epfl-mobots/e-puck3-coreboard/Programmer_pinout_rev1.txt

Configuration	Programmer_pinout_rev1
STM32CubeMX 	5.5.0
Date	07/27/2020
MCU	STM32F746ZGYx

PERIPHERALS	MODES	FUNCTIONS	PINS
ADC1	IN0	ADC1_IN0	PA0/WKUP
ADC1	IN11	ADC1_IN11	PC1
ADC1	Single-ended	ADC1_TempSens_Input	VP_ADC1_TempSens_Input
ADC1	Vrefint Channel	ADC1_Vref_Input	VP_ADC1_Vref_Input
ADC2	IN4	ADC2_IN4	PA4
ADC2	IN5	ADC2_IN5	PA5
ADC2	IN6	ADC2_IN6	PA6
ADC2	IN9	ADC2_IN9	PB1
ADC2	IN12	ADC2_IN12	PC2
ADC2	IN13	ADC2_IN13	PC3
ADC2	IN14	ADC2_IN14	PC4
ADC2	IN15	ADC2_IN15	PC5
ADC3	IN1	ADC3_IN1	PA1
ADC3	IN2	ADC3_IN2	PA2
ADC3	IN3	ADC3_IN3	PA3
ADC3	IN4	ADC3_IN4	PF6
ADC3	IN5	ADC3_IN5	PF7
ADC3	IN6	ADC3_IN6	PF8
ADC3	IN7	ADC3_IN7	PF9
ADC3	IN8	ADC3_IN8	PF10
ADC3	IN9	ADC3_IN9	PF3
ADC3	IN10	ADC3_IN10	PC0
ADC3	IN14	ADC3_IN14	PF4
ADC3	IN15	ADC3_IN15	PF5
CAN1	Master	CAN1_RX	PD0
CAN1	Master	CAN1_TX	PD1
I2C4	I2C	I2C4_SCL	PF14
I2C4	I2C	I2C4_SDA	PD13
RCC	BYPASS Clock Source	RCC_OSC_IN	PH0/OSC_IN
RCC	BYPASS Clock Source	RCC_OSC_OUT	PH1/OSC_OUT
SPI6	Full-Duplex Master	SPI6_MISO	PG12
SPI6	Full-Duplex Master	SPI6_MOSI	PG14
SPI6	Full-Duplex Master	SPI6_SCK	PG13
SYS	Serial Wire	SYS_JTCK-SWCLK	PA14
SYS	Serial Wire	SYS_JTMS-SWDIO	PA13
SYS	SysTick	SYS_VS_Systick	VP_SYS_VS_Systick
TIM1	ITR0	TIM1_VS_ClockSourceITR	VP_TIM1_VS_ClockSourceITR
TIM1	Internal Clock	TIM1_VS_ClockSourceINT	VP_TIM1_VS_ClockSourceINT
TIM1	PWM Generation CH1 CH1N	TIM1_CH1	PE9
TIM1	PWM Generation CH1 CH1N	TIM1_CH1N	PE8
TIM1	PWM Generation CH2 CH2N	TIM1_CH2	PE11
TIM1	PWM Generation CH2 CH2N	TIM1_CH2N	PE10
TIM1	PWM Generation CH3 CH3N	TIM1_CH3	PE13
TIM1	PWM Generation CH3 CH3N	TIM1_CH3N	PE12
TIM2	Trigger Mode	TIM2_VS_ControllerModeTrigger	VP_TIM2_VS_ControllerModeTrigger
TIM2	ITR0	TIM2_VS_ClockSourceITR	VP_TIM2_VS_ClockSourceITR
TIM2	Internal Clock	TIM2_VS_ClockSourceINT	VP_TIM2_VS_ClockSourceINT
TIM2	PWM Generation CH1	TIM2_CH1	PA15
TIM2	PWM Generation CH2	TIM2_CH2	PB3
TIM2	PWM Generation CH3	TIM2_CH3	PB10
TIM2	PWM Generation CH4	TIM2_CH4	PB11
TIM3	Trigger Mode	TIM3_VS_ControllerModeTrigger	VP_TIM3_VS_ControllerModeTrigger
TIM3	ITR0	TIM3_VS_ClockSourceITR	VP_TIM3_VS_ClockSourceITR
TIM3	PWM Generation CH1	TIM3_CH1	PB4
TIM3	PWM Generation CH2	TIM3_CH2	PB5
TIM3	PWM Generation CH3	TIM3_CH3	PB0
TIM3	PWM Generation CH4	TIM3_CH4	PC9
TIM4	Trigger Mode	TIM4_VS_ControllerModeTrigger	VP_TIM4_VS_ControllerModeTrigger
TIM4	ITR0	TIM4_VS_ClockSourceITR	VP_TIM4_VS_ClockSourceITR
TIM4	Internal Clock	TIM4_VS_ClockSourceINT	VP_TIM4_VS_ClockSourceINT
TIM4	PWM Generation CH1	TIM4_CH1	PD12
TIM4	PWM Generation CH2	TIM4_CH2	PB7
TIM4	PWM Generation CH3	TIM4_CH3	PD14
TIM4	PWM Generation CH4	TIM4_CH4	PD15
TIM8	Trigger Mode	TIM8_VS_ControllerModeTrigger	VP_TIM8_VS_ControllerModeTrigger
TIM8	ITR0	TIM8_VS_ClockSourceITR	VP_TIM8_VS_ClockSourceITR
TIM8	Internal Clock	TIM8_VS_ClockSourceINT	VP_TIM8_VS_ClockSourceINT
TIM8	PWM Generation CH1 CH1N	TIM8_CH1	PC6
TIM8	PWM Generation CH1 CH1N	TIM8_CH1N	PA7
TIM8	PWM Generation CH2 CH2N	TIM8_CH2	PC7
TIM8	PWM Generation CH2 CH2N	TIM8_CH2N	PB14
TIM8	PWM Generation CH3 CH3N	TIM8_CH3	PC8
TIM8	PWM Generation CH3 CH3N	TIM8_CH3N	PB15
UART8	Asynchronous	UART8_RX	PE0
UART8	Asynchronous	UART8_TX	PE1
USART1	Asynchronous	USART1_RX	PA10
USART1	Asynchronous	USART1_TX	PB6
USART3	Asynchronous	USART3_RX	PC11
USART3	Asynchronous	USART3_TX	PC10
USB_OTG_FS	Device_Only	USB_OTG_FS_DM	PA11
USB_OTG_FS	Device_Only	USB_OTG_FS_DP	PA12
USB_OTG_FS	VBUS	USB_OTG_FS_VBUS	PA9

Pin Nb	PINs	FUNCTIONs	LABELs
A2	PC10	USART3_TX	UART_uC_ESP_TX
A3	PD2	GPIO_Output	STATUS_LED1_R
A4	PD5	GPIO_Output	STATUS_LED2_R
A5	PD7	GPIO_Output	STATUS_LED2_B
A6	PG12	SPI6_MISO	ENCODERS_GATE_DRIVERS
A8	PB6	USART1_TX	UART_PROG_ESP
A9	PB8	GPIO_Output	EN_ESP32
A10	PE1	UART8_TX	UART_CMD
B1	PA14	SYS_JTCK-SWCLK	
B2	PC11	USART3_RX	UART_uC_ESP_RX
B3	PD0	CAN1_RX	
B4	PD3	GPIO_Output	STATUS_LED1_G
B5	PD4	GPIO_Output	STATUS_LED1_B
B6	PG11	GPIO_Output	EN_DRIVER_3
B7	PB3	TIM2_CH2	H_bridge_mot2AN
B8	PB7	TIM4_CH2	H_bridge_mot3BN
B9	PB9	GPIO_Output	GPIO0_ESP32
B10	PE0	UART8_RX	UART_CMD
C2	PA15	TIM2_CH1	H_bridge_mot2AP
C3	PC12	GPIO_Output	EN_EXTENSION_TOP
C4	PD1	CAN1_TX	
C6	PG10	GPIO_EXTI10	PWR_ON_BTN_STATE_n
C7	PB4	TIM3_CH1	H_bridge_mot2CP
C8	PB5	TIM3_CH2	H_bridge_mot2CN
C10	PE3	GPIO_Output	GPIO4_ESP32
D3	PA13	SYS_JTMS-SWDIO	
D4	PA11	USB_OTG_FS_DM	
D5	PA10	USART1_RX	UART_PROG_ESP
D6	PG13	SPI6_SCK	ENCODERS_GATE_DRIVERS
D8	PE2	GPIO_Output	EN_DRIVER_4
D9	PE5	GPIO_Output	SWD_uC_SWCLK
E1	PA12	USB_OTG_FS_DP	
E2	PA9	USB_OTG_FS_VBUS	
E3	PC9	TIM3_CH4	H_bridge_mot3AN
E4	PC8	TIM8_CH3	H_bridge_mot4CP
E5	PG9	GPIO_Output	EN_EXTENSION_BOTTOM
E8	PE6	GPIO_Output	SWD_uC_SWDIO
E9	PF1	GPIO_Output	HUB_CONNECT
F1	PA8	GPIO_Output	RESET_HUB_n
F2	PC6	TIM8_CH1	H_bridge_mot4AP
F3	PC7	TIM8_CH2	H_bridge_mot4BP
F4	PD6	GPIO_Output	STATUS_LED2_G
F6	PG14	SPI6_MOSI	ENCODERS_GATE_DRIVERS
F7	PF7	ADC3_IN5	Brushless_sense_mot1A
F8	PF5	ADC3_IN15	Brushless_sense_mot1C
F9	PF4	ADC3_IN14	Brushless_sense_mot1B
F10	PF2	GPIO_Output	EN_DRIVER_2
F11	PF0	GPIO_Output	GPIO13_ESP32
G2	PG8	GPIO_Output	BYPASS_HUB_n
G3	PG3	GPIO_EXTI3	FAULT_DRIVER_3_n
G4	PG6	GPIO_Output	VBUS_DEVICES
G5	PG4	GPIO_EXTI4	VBUS_HOST
G6	PG5	GPIO_EXTI5	INT_PD_CTRL_n
G8	PF9	ADC3_IN7	Brushless_sense_mot2A
G9	PF10	ADC3_IN8	Brushless_sense_mot2B
G10	PF6	ADC3_IN4	Brushless_sense_mot3A
G11	PF3	ADC3_IN9	Brushless_sense_mot3C
H4	PD10	GPIO_Output	STATUS_LED3_B
H5	PD13	I2C4_SDA	I2C_PD_CONTROLLER
H6	PD12	TIM4_CH1	H_bridge_mot3BP
H8	PC0	ADC3_IN10	Brushless_sense_mot2C
H10	PH1/OSC_OUT	RCC_OSC_OUT	
H11	PF8	ADC3_IN6	Brushless_sense_mot3B
J1	PG2	GPIO_EXTI2	FAULT_DRIVER_4_n
J2	PD14	TIM4_CH3	H_bridge_mot3CP
J3	PB15	TIM8_CH3N	H_bridge_mot4CN
J4	PE10	TIM1_CH2N	H_bridge_mot1BN
J9	PC3	ADC2_IN13	Current_sense_mot1B
J10	PC2	ADC2_IN12	Current_sense_mot1A
J11	PH0/OSC_IN	RCC_OSC_IN	_24MHz_IN
K1	PD15	TIM4_CH4	H_bridge_mot3CN
K2	PD11	GPIO_Output	CS_ENCODER1_n
K3	PB14	TIM8_CH2N	H_bridge_mot4BN
K4	PE11	TIM1_CH2	H_bridge_mot1BP
K5	PG1	GPIO_EXTI1	FAULT_DRIVER_2_n
K6	PF13	GPIO_Output	CS_ENCODER4_n
K7	PB1	ADC2_IN9	Current_sense_mot4A
K8	PA1	ADC3_IN1	Brushless_sense_mot4A
K9	PA0/WKUP	ADC1_IN0	VBUS_sense
K11	PC1	ADC1_IN11	BAT+_sense
L2	PD8	GPIO_Output	STATUS_LED3_R
L3	PE15	GPIO_Output	RESET_uC
L4	PE12	TIM1_CH3N	H_bridge_mot1CN
L5	PE7	GPIO_Output	CS_ENCODER2_n
L6	PF14	I2C4_SCL	I2C_PD_CONTROLLER
L7	PB2	GPIO_Output	BAT+_INRUSH_LIMIT_n
L8	PA7	TIM8_CH1N	H_bridge_mot4AN
L9	PA2	ADC3_IN2	Brushless_sense_mot4B
M1	PD9	GPIO_Output	STATUS_LED3_G
M2	PB12	GPIO_Output	PWR_ON
M3	PB10	TIM2_CH3	H_bridge_mot2BP
M4	PE14	GPIO_Output	CS_ENCODER3_n
M5	PE8	TIM1_CH1N	H_bridge_mot1AN
M6	PF15	GPIO_Output	EN_DRIVER_1
M7	PF11	GPIO_Output	PRIORITY_TO_VBUS
M8	PC4	ADC2_IN14	Current_sense_mot4B
M9	PA5	ADC2_IN5	Current_sense_mot2B
M10	PA4	ADC2_IN4	Current_sense_mot2A
M11	PA3	ADC3_IN3	Brushless_sense_mot4C
N1	PB13	GPIO_Output	EN_CAN_PROG_n
N3	PB11	TIM2_CH4	H_bridge_mot2BN
N4	PE13	TIM1_CH3	H_bridge_mot1CP
N5	PE9	TIM1_CH1	H_bridge_mot1AP
N6	PG0	GPIO_EXTI0	FAULT_DRIVER_1_n
N8	PB0	TIM3_CH3	H_bridge_mot3AP
N9	PC5	ADC2_IN15	Current_sense_mot3B
N10	PA6	ADC2_IN6	Current_sense_mot3A
PERIPHERALS	MODES	FUNCTIONS	PINS
ADC1	IN0	ADC1_IN0	PA0/WKUP
ADC1	IN11	ADC1_IN11	PC1
ADC1	Single-ended	ADC1_TempSens_Input	VP_ADC1_TempSens_Input
ADC1	Vrefint Channel	ADC1_Vref_Input	VP_ADC1_Vref_Input
ADC2	IN4	ADC2_IN4	PA4
ADC2	IN5	ADC2_IN5	PA5
ADC2	IN6	ADC2_IN6	PA6
ADC2	IN9	ADC2_IN9	PB1
ADC2	IN12	ADC2_IN12	PC2
ADC2	IN13	ADC2_IN13	PC3
ADC2	IN14	ADC2_IN14	PC4
ADC2	IN15	ADC2_IN15	PC5
ADC3	IN1	ADC3_IN1	PA1
ADC3	IN2	ADC3_IN2	PA2
ADC3	IN3	ADC3_IN3	PA3
ADC3	IN4	ADC3_IN4	PF6
ADC3	IN5	ADC3_IN5	PF7
ADC3	IN6	ADC3_IN6	PF8
ADC3	IN7	ADC3_IN7	PF9
ADC3	IN8	ADC3_IN8	PF10
ADC3	IN9	ADC3_IN9	PF3
ADC3	IN10	ADC3_IN10	PC0
ADC3	IN14	ADC3_IN14	PF4
ADC3	IN15	ADC3_IN15	PF5
CAN1	Master	CAN1_RX	PD0
CAN1	Master	CAN1_TX	PD1
I2C4	I2C	I2C4_SCL	PF14
I2C4	I2C	I2C4_SDA	PD13
RCC	BYPASS Clock Source	RCC_OSC_IN	PH0/OSC_IN
RCC	BYPASS Clock Source	RCC_OSC_OUT	PH1/OSC_OUT
SPI6	Full-Duplex Master	SPI6_MISO	PG12
SPI6	Full-Duplex Master	SPI6_MOSI	PG14
SPI6	Full-Duplex Master	SPI6_SCK	PG13
SYS	Serial Wire	SYS_JTCK-SWCLK	PA14
SYS	Serial Wire	SYS_JTMS-SWDIO	PA13
SYS	SysTick	SYS_VS_Systick	VP_SYS_VS_Systick
TIM1	ITR0	TIM1_VS_ClockSourceITR	VP_TIM1_VS_ClockSourceITR
TIM1	Internal Clock	TIM1_VS_ClockSourceINT	VP_TIM1_VS_ClockSourceINT
TIM1	PWM Generation CH1 CH1N	TIM1_CH1	PE9
TIM1	PWM Generation CH1 CH1N	TIM1_CH1N	PE8
TIM1	PWM Generation CH2 CH2N	TIM1_CH2	PE11
TIM1	PWM Generation CH2 CH2N	TIM1_CH2N	PE10
TIM1	PWM Generation CH3 CH3N	TIM1_CH3	PE13
TIM1	PWM Generation CH3 CH3N	TIM1_CH3N	PE12
TIM2	Trigger Mode	TIM2_VS_ControllerModeTrigger	VP_TIM2_VS_ControllerModeTrigger
TIM2	ITR0	TIM2_VS_ClockSourceITR	VP_TIM2_VS_ClockSourceITR
TIM2	Internal Clock	TIM2_VS_ClockSourceINT	VP_TIM2_VS_ClockSourceINT
TIM2	PWM Generation CH1	TIM2_CH1	PA15
TIM2	PWM Generation CH2	TIM2_CH2	PB3
TIM2	PWM Generation CH3	TIM2_CH3	PB10
TIM2	PWM Generation CH4	TIM2_CH4	PB11
TIM3	Trigger Mode	TIM3_VS_ControllerModeTrigger	VP_TIM3_VS_ControllerModeTrigger
TIM3	ITR0	TIM3_VS_ClockSourceITR	VP_TIM3_VS_ClockSourceITR
TIM3	PWM Generation CH1	TIM3_CH1	PB4
TIM3	PWM Generation CH2	TIM3_CH2	PB5
TIM3	PWM Generation CH3	TIM3_CH3	PB0
TIM3	PWM Generation CH4	TIM3_CH4	PC9
TIM4	Trigger Mode	TIM4_VS_ControllerModeTrigger	VP_TIM4_VS_ControllerModeTrigger
TIM4	ITR0	TIM4_VS_ClockSourceITR	VP_TIM4_VS_ClockSourceITR
TIM4	Internal Clock	TIM4_VS_ClockSourceINT	VP_TIM4_VS_ClockSourceINT
TIM4	PWM Generation CH1	TIM4_CH1	PD12
TIM4	PWM Generation CH2	TIM4_CH2	PB7
TIM4	PWM Generation CH3	TIM4_CH3	PD14
TIM4	PWM Generation CH4	TIM4_CH4	PD15
TIM8	Trigger Mode	TIM8_VS_ControllerModeTrigger	VP_TIM8_VS_ControllerModeTrigger
TIM8	ITR0	TIM8_VS_ClockSourceITR	VP_TIM8_VS_ClockSourceITR
TIM8	Internal Clock	TIM8_VS_ClockSourceINT	VP_TIM8_VS_ClockSourceINT
TIM8	PWM Generation CH1 CH1N	TIM8_CH1	PC6
TIM8	PWM Generation CH1 CH1N	TIM8_CH1N	PA7
TIM8	PWM Generation CH2 CH2N	TIM8_CH2	PC7
TIM8	PWM Generation CH2 CH2N	TIM8_CH2N	PB14
TIM8	PWM Generation CH3 CH3N	TIM8_CH3	PC8
TIM8	PWM Generation CH3 CH3N	TIM8_CH3N	PB15
UART8	Asynchronous	UART8_RX	PE0
UART8	Asynchronous	UART8_TX	PE1
USART1	Asynchronous	USART1_RX	PA10
USART1	Asynchronous	USART1_TX	PB6
USART3	Asynchronous	USART3_RX	PC11
USART3	Asynchronous	USART3_TX	PC10
USB_OTG_FS	Device_Only	USB_OTG_FS_DM	PA11
USB_OTG_FS	Device_Only	USB_OTG_FS_DP	PA12
USB_OTG_FS	VBUS	USB_OTG_FS_VBUS	PA9

Pin Nb	PINs	FUNCTIONs	LABELs
A2	PC10	USART3_TX	UART_uC_ESP_TX
A3	PD2	GPIO_Output	STATUS_LED1_R
A4	PD5	GPIO_Output	STATUS_LED2_R
A5	PD7	GPIO_Output	STATUS_LED2_B
A6	PG12	SPI6_MISO	ENCODERS_GATE_DRIVERS
A8	PB6	USART1_TX	UART_PROG_ESP
A9	PB8	GPIO_Output	EN_ESP32
A10	PE1	UART8_TX	UART_CMD
B1	PA14	SYS_JTCK-SWCLK	
B2	PC11	USART3_RX	UART_uC_ESP_RX
B3	PD0	CAN1_RX	
B4	PD3	GPIO_Output	STATUS_LED1_G
B5	PD4	GPIO_Output	STATUS_LED1_B
B6	PG11	GPIO_Output	EN_DRIVER_3
B7	PB3	TIM2_CH2	H_bridge_mot2AN
B8	PB7	TIM4_CH2	H_bridge_mot3BN
B9	PB9	GPIO_Output	GPIO0_ESP32
B10	PE0	UART8_RX	UART_CMD
C2	PA15	TIM2_CH1	H_bridge_mot2AP
C3	PC12	GPIO_Output	EN_EXTENSION_TOP
C4	PD1	CAN1_TX	
C6	PG10	GPIO_EXTI10	PWR_ON_BTN_STATE_n
C7	PB4	TIM3_CH1	H_bridge_mot2CP
C8	PB5	TIM3_CH2	H_bridge_mot2CN
C10	PE3	GPIO_Output	GPIO4_ESP32
D3	PA13	SYS_JTMS-SWDIO	
D4	PA11	USB_OTG_FS_DM	
D5	PA10	USART1_RX	UART_PROG_ESP
D6	PG13	SPI6_SCK	ENCODERS_GATE_DRIVERS
D8	PE2	GPIO_Output	EN_DRIVER_4
D9	PE5	GPIO_Output	SWD_uC_SWCLK
E1	PA12	USB_OTG_FS_DP	
E2	PA9	USB_OTG_FS_VBUS	
E3	PC9	TIM3_CH4	H_bridge_mot3AN
E4	PC8	TIM8_CH3	H_bridge_mot4CP
E5	PG9	GPIO_Output	EN_EXTENSION_BOTTOM
E8	PE6	GPIO_Output	SWD_uC_SWDIO
E9	PF1	GPIO_Output	HUB_CONNECT
F1	PA8	GPIO_Output	RESET_HUB_n
F2	PC6	TIM8_CH1	H_bridge_mot4AP
F3	PC7	TIM8_CH2	H_bridge_mot4BP
F4	PD6	GPIO_Output	STATUS_LED2_G
F6	PG14	SPI6_MOSI	ENCODERS_GATE_DRIVERS
F7	PF7	ADC3_IN5	Brushless_sense_mot1A
F8	PF5	ADC3_IN15	Brushless_sense_mot1C
F9	PF4	ADC3_IN14	Brushless_sense_mot1B
F10	PF2	GPIO_Output	EN_DRIVER_2
F11	PF0	GPIO_Output	GPIO13_ESP32
G2	PG8	GPIO_Output	BYPASS_HUB_n
G3	PG3	GPIO_EXTI3	FAULT_DRIVER_3_n
G4	PG6	GPIO_Output	VBUS_DEVICES
G5	PG4	GPIO_EXTI4	VBUS_HOST
G6	PG5	GPIO_EXTI5	INT_PD_CTRL_n
G8	PF9	ADC3_IN7	Brushless_sense_mot2A
G9	PF10	ADC3_IN8	Brushless_sense_mot2B
G10	PF6	ADC3_IN4	Brushless_sense_mot3A
G11	PF3	ADC3_IN9	Brushless_sense_mot3C
H4	PD10	GPIO_Output	STATUS_LED3_B
H5	PD13	I2C4_SDA	I2C_PD_CONTROLLER
H6	PD12	TIM4_CH1	H_bridge_mot3BP
H8	PC0	ADC3_IN10	Brushless_sense_mot2C
H10	PH1/OSC_OUT	RCC_OSC_OUT	
H11	PF8	ADC3_IN6	Brushless_sense_mot3B
J1	PG2	GPIO_EXTI2	FAULT_DRIVER_4_n
J2	PD14	TIM4_CH3	H_bridge_mot3CP
J3	PB15	TIM8_CH3N	H_bridge_mot4CN
J4	PE10	TIM1_CH2N	H_bridge_mot1BN
J9	PC3	ADC2_IN13	Current_sense_mot1B
J10	PC2	ADC2_IN12	Current_sense_mot1A
J11	PH0/OSC_IN	RCC_OSC_IN	_24MHz_IN
K1	PD15	TIM4_CH4	H_bridge_mot3CN
K2	PD11	GPIO_Output	CS_ENCODER1_n
K3	PB14	TIM8_CH2N	H_bridge_mot4BN
K4	PE11	TIM1_CH2	H_bridge_mot1BP
K5	PG1	GPIO_EXTI1	FAULT_DRIVER_2_n
K6	PF13	GPIO_Output	CS_ENCODER4_n
K7	PB1	ADC2_IN9	Current_sense_mot4A
K8	PA1	ADC3_IN1	Brushless_sense_mot4A
K9	PA0/WKUP	ADC1_IN0	VBUS_sense
K11	PC1	ADC1_IN11	BAT+_sense
L2	PD8	GPIO_Output	STATUS_LED3_R
L3	PE15	GPIO_Output	RESET_uC
L4	PE12	TIM1_CH3N	H_bridge_mot1CN
L5	PE7	GPIO_Output	CS_ENCODER2_n
L6	PF14	I2C4_SCL	I2C_PD_CONTROLLER
L7	PB2	GPIO_Output	BAT+_INRUSH_LIMIT_n
L8	PA7	TIM8_CH1N	H_bridge_mot4AN
L9	PA2	ADC3_IN2	Brushless_sense_mot4B
M1	PD9	GPIO_Output	STATUS_LED3_G
M2	PB12	GPIO_Output	PWR_ON
M3	PB10	TIM2_CH3	H_bridge_mot2BP
M4	PE14	GPIO_Output	CS_ENCODER3_n
M5	PE8	TIM1_CH1N	H_bridge_mot1AN
M6	PF15	GPIO_Output	EN_DRIVER_1
M7	PF11	GPIO_Output	PRIORITY_TO_VBUS
M8	PC4	ADC2_IN14	Current_sense_mot4B
M9	PA5	ADC2_IN5	Current_sense_mot2B
M10	PA4	ADC2_IN4	Current_sense_mot2A
M11	PA3	ADC3_IN3	Brushless_sense_mot4C
N1	PB13	GPIO_Output	EN_CAN_PROG_n
N3	PB11	TIM2_CH4	H_bridge_mot2BN
N4	PE13	TIM1_CH3	H_bridge_mot1CP
N5	PE9	TIM1_CH1	H_bridge_mot1AP
N6	PG0	GPIO_EXTI0	FAULT_DRIVER_1_n
N8	PB0	TIM3_CH3	H_bridge_mot3AP
N9	PC5	ADC2_IN15	Current_sense_mot3B
N10	PA6	ADC2_IN6	Current_sense_mot3A

SOFTWARE PROJECT

Project Settings : 
Project Name : Programmer_pinout_rev1
Project Folder : /Users/eliot/Documents/SmartGit/e-puck3-coreboard
Toolchain / IDE : EWARM V8
Firmware Package Name and Version : STM32Cube FW_F7 V1.15.0

Code Generation Settings : 
STM32Cube MCU packages and embedded software packs : Copy all used libraries into the project folder
Generate peripheral initialization as a pair of '.c/.h' files per peripheral : No
Backup previously generated files when re-generating : No
Delete previously generated files when not re-generated : Yes
Set all free pins as analog (to optimize the power consumption) : No

Toolchains Settings : 
Compiler Optimizations :
