epfl-mobots/e-puck3-coreboard/(list of files, drawings)

Other design files:
Camera_sdcard.SchDoc
e-puck3-coreboard.PrjPcb
e-puck3-coreboard_panel.PcbDoc
ESC_2S-5S.SchDoc
Extension_Connectors.SchDoc
Leds.SchDoc
Main.SchDoc
Main_uC.SchDoc
Power.SchDoc
Programmer.SchDoc
Schlib.SchLib
Sensors + CAN.SchDoc
USB.SchDoc
Wireless.SchDoc
