epfl-mobots/e-puck3-coreboard/Main_uC_pinout_rev1.1.ioc

Mcu.UserName=STM32F779AIYx
PA0/WKUP.Signal=ADCx_IN0
PA1.Signal=ADCx_IN1
PA10.Signal=DCMI_D1
PA11.Signal=USB_OTG_FS_DM
PA12.Signal=USB_OTG_FS_DP
PA13.Signal=SYS_JTMS-SWDIO
PA14.Signal=SYS_JTCK-SWCLK
PA15.Signal=UART7_TX
PA2.Signal=ADCx_IN2
PA3.Signal=USB_OTG_HS_ULPI_D0
PA4.Signal=COMP_DAC1_group
PA5.Signal=USB_OTG_HS_ULPI_CK
PA6.Signal=DCMI_PIXCLK
PA7.GPIO_Label=SDMC_DET_n
PA7.Signal=GPIO_Input
PA8.GPIO_Label=MHz_26_clk_out
PA8.Signal=RCC_MCO_1
PA9.Signal=USB_OTG_FS_VBUS
PB0.Signal=USB_OTG_HS_ULPI_D1
PB1.Signal=USB_OTG_HS_ULPI_D2
PB10.Signal=USB_OTG_HS_ULPI_D3
PB11.Signal=USB_OTG_HS_ULPI_D4
PB12.Signal=USB_OTG_HS_ULPI_D5
PB13.Signal=USB_OTG_HS_ULPI_D6
PB14.GPIO_Label=SPI_IMU_PRESS
PB14.Signal=SPI2_MISO
PB15.GPIO_Label=SPI_IMU_PRESS
PB15.Signal=SPI2_MOSI
PB2.GPIO_Label=SPI_EPS32
PB2.Signal=SPI3_MOSI
PB3.GPIO_Label=SPI_EPS32
PB3.Signal=SPI3_SCK
PB4.GPIO_Label=SPI_EPS32
PB4.Signal=SPI3_MISO
PB5.Signal=USB_OTG_HS_ULPI_D7
PB6.Signal=I2C1_SCL
PB7.Signal=I2C1_SDA
PB8.GPIO_Label=UART_ESP32_PROG
PB8.Signal=UART5_RX
PB9.GPIO_Label=UART_ESP32_PROG
PB9.Signal=UART5_TX
PC0.Signal=USB_OTG_HS_ULPI_STP
PC1.Signal=ADCx_IN11
PC10.Signal=SDMMC1_D2
PC11.Signal=SDMMC1_D3
PC12.Signal=SDMMC1_CK
PC6.Signal=USART6_TX
PC7.Signal=USART6_RX
PC8.Signal=SDMMC1_D0
PC9.Signal=SDMMC1_D1
PD0.Signal=CAN1_RX
PD1.Signal=CAN1_TX
PD10.Signal=S_CKOUTDFSDM1
PD11.GPIO_Label=PRESS_INT
PD11.Signal=GPIO_Input
PD12.Signal=I2C4_SCL
PD13.Signal=I2C4_SDA
PD14.GPIO_Label=FORCE_MAIN_UC
PD14.Signal=GPIO_Output
PD15.GPIO_Label=EXTCLK_camera
PD15.Signal=S_TIM4_CH4
PD2.Signal=SDMMC1_CMD
PD3.GPIO_Label=SPI_IMU_PRESS
PD3.Signal=SPI2_SCK
PD4.GPIO_Label=IMU_INT1
PD4.Signal=GPIO_Input
PD5.Signal=USART2_TX
PD6.Signal=USART2_RX
PD7.Signal=SPI1_MOSI
PD8.GPIO_Label=UART_CMD_PROG
PD8.Signal=USART3_TX
PD9.GPIO_Label=UART_CMD_PROG
PD9.Signal=USART3_RX
PE0.GPIO_Label=OE_CAM1_n
PE0.Signal=GPIO_Output
PE1.GPIO_Label=OE_CAM2_n
PE1.Signal=GPIO_Output
PE10.Signal=UART7_CTS
PE11.GPIO_Label=SPI_ESP_CS_n
PE11.Signal=GPIO_Output
PE12.GPIO_Label=MIC34
PE12.Signal=S_DATAIN5DFSDM1
PE13.GPIO_Label=FRONT_RGB_R
PE13.Signal=GPIO_Output
PE14.GPIO_Label=FRONT_RGB_G
PE14.Signal=GPIO_Output
PE15.GPIO_Label=FRONT_RGB_B
PE15.Signal=GPIO_Output
PE2.Signal=SPI4_SCK
PE3.GPIO_Label=IR_SIGNAL
PE3.Signal=GPIO_Input
PE4.GPIO_Label=MIC12
PE4.Signal=S_DATAIN3DFSDM1
PE5.Signal=SPI4_MISO
PE6.Signal=SPI4_MOSI
PE7.Signal=UART7_RX
PE8.GPIO_Label=IMU_INT2
PE8.Signal=GPIO_Input
PE9.Signal=UART7_RTS
PF0.GPIO_Label=USER_BUTTON_n
PF0.Signal=GPIO_Input
PF1.Signal=I2C2_SCL
PF10.Signal=ADC3_IN8
PF11.GPIO_Label=CS_IMU_n
PF11.Signal=GPIO_Output
PF12.GPIO_Label=CS_PRESS_n
PF12.Signal=GPIO_Output
PF13.GPIO_Label=RIGHT_RGB_R
PF13.Signal=GPIO_Output
PF14.GPIO_Label=RIGHT_RGB_G
PF14.Signal=GPIO_Output
PF15.GPIO_Label=RIGHT_RGB_B
PF15.Signal=GPIO_Output
PF2.GPIO_Label=POWER_ON
PF2.Signal=GPIO_Output
PF3.Signal=ADC3_IN9
PF4.Signal=ADC3_IN14
PF5.Signal=ADC3_IN15
PG0.GPIO_Label=REAR_RGB_R
PG0.Signal=GPIO_Output
PG1.GPIO_Label=REAR_RGB_G
PG1.Signal=GPIO_Output
PG10.Signal=DCMI_D2
PG11.Signal=SPI1_SCK
PG12.Signal=USART6_RTS
PG13.Signal=USART6_CTS
PG15.GPIO_Label=EN_CAN_uC_n
PG15.Signal=GPIO_Output
PG2.GPIO_Label=REAR_RGB_B
PG2.Signal=GPIO_Output
PG3.GPIO_Label=LEFT_RGB_R
PG3.Signal=GPIO_Output
PG4.GPIO_Label=LEFT_RGB_G
PG4.Signal=GPIO_Output
PG5.GPIO_Label=LEFT_RGB_B
PG5.Signal=GPIO_Output
PG7.GPIO_Label=SWCLK_prog
PG7.Signal=GPIO_Output
PG8.GPIO_Label=SWDIO_prog
PG8.Signal=GPIO_Output
PG9.Signal=SPI1_MISO
PH0/OSC_IN.Signal=RCC_OSC_IN
PH1/OSC_OUT.Signal=RCC_OSC_OUT
PH10.GPIO_Label=EN_CAM1
PH10.Signal=GPIO_Output
PH11.GPIO_Label=EN_CAM2
PH11.Signal=GPIO_Output
PH12.Signal=DCMI_D3
PH13.Signal=UART4_TX
PH14.Signal=DCMI_D4
PH15.Signal=DCMI_D11
PH2.GPIO_Label=PWR_BTN_STATE_n
PH2.Signal=GPIO_Input
PH3.GPIO_Label=EN_DIST
PH3.Signal=GPIO_Output
PH4.Signal=USB_OTG_HS_ULPI_NXT
PH5.Signal=I2C2_SDA
PH8.Signal=DCMI_HSYNC
PH9.Signal=DCMI_D0
PI1.Signal=DCMI_D8
PI10.GPIO_Label=EN_PHY_HS
PI10.Signal=GPIO_Output
PI11.Signal=USB_OTG_HS_ULPI_DIR
PI2.Signal=DCMI_D9
PI3.Signal=DCMI_D10
PI4.Signal=DCMI_D5
PI5.Signal=DCMI_VSYNC
PI6.Signal=DCMI_D6
PI7.Signal=DCMI_D7
PI9.Signal=UART4_RX
