epfl-mobots/e-puck3-coreboard/(commit log)

2018-10-16 Create e-puck3-coreboard from e-puck2 base. Only schematic at this time.
    [82674SMD.stp, ACCU.sldprt, BODY_TCNT1000_ASM.sldasm, CAMERA.sldprt, CAN_Audio.SchDoc, COLORRING.sldprt, CONN_BTE9.sldprt, CONTACT-ARRIERE.sldprt]
2018-10-16 Remove all SchDoc files except Main
    [CAN_Audio.SchDoc, Cameras.SchDoc, I2C_Sensors.SchDoc, LEDs.SchDoc, Microcontroller.SchDoc, Motors_Encoders.SchDoc, Powers.SchDoc, Programmer.SchDoc]
2018-10-16 Remove .models directory
    [ACCU.sldprt, BODY_TCNT1000_ASM.sldasm, CAMERA.sldprt, COLORRING.sldprt, CONN_BTE9.sldprt, CONTACT-ARRIERE.sldprt, CONTACT-AVANT.sldprt, E-JUMPERFUN.sldprt]
2018-10-16 Remove steps directory
    [82674SMD.stp, ZX62D-B-5PA8.stp]
2018-10-16 Updated "template" files (empty project)
    [Main.SchDoc, e-puck3-coreboard.PrjPcb]
2018-10-17 Correct TemplateLocationPath
    [e-puck3-coreboard.PrjPcb]
2018-10-18 Added Power Sheet
    [Power.SchDoc, e-puck3-coreboard.PrjPcb]
2018-10-18 Added Library
    [Power.SchDoc, Schlib.SchLib, e-puck3-coreboard.PrjPcb]
2018-10-18 Added 3.3V DC/DC schematic
    [Power.SchDoc, Schlib.SchLib, e-puck3-coreboard.PrjPcb]
2018-10-19 -Updated some components schematics and footprints
    [Schlib.SchLib]
2018-10-19 First draft of Power sheet
    [Power.SchDoc]
2018-10-24 Added new components and corrected others
    [Schlib.SchLib]
2018-10-24 Corrected PR1 connection + minor changes
    [Power.SchDoc]
2018-10-24 -Added USB sheet
    [USB.SchDoc, e-puck3-coreboard.PrjPcb]
2018-10-24 -Added 24MHz oscillator -Added FUSB302
    [Schlib.SchLib]
2018-10-24 -Added FUSB302
    [USB.SchDoc]
2018-10-24 -Added asc711 hall sensor
    [Schlib.SchLib]
2018-10-25 -Added current measurement of the USB source
    [Power.SchDoc]
2018-10-25 Added STM32F413AxY
    [Schlib.SchLib]
2018-10-25 -Added USB-C connector
    [Schlib.SchLib, USB.SchDoc]
2018-10-26 Updated MOLEX_2012670005 footprint
2018-10-26 -Added pull-up for I2C bus of FUSB302
    [USB.SchDoc]
2018-10-26 -Added LEDs sheet
    [Leds.SchDoc, e-puck3-coreboard.PrjPcb]
2018-10-26 -Added sensors + CAN sheet
    [Sensors + CAN.SchDoc, e-puck3-coreboard.PrjPcb]
2018-10-29 -Corrected IMU connections -Changes connections CAN -Added possibility to enable/disable the CAN transceivers -Changed project properties from Flat to Hierachical -Added the 4 microphones
    [Sensors + CAN.SchDoc, e-puck3-coreboard.PrjPcb]
2018-10-29 -Added wireless sheet -Added ESP32
    [Wireless.SchDoc, e-puck3-coreboard.PrjPcb]
2018-10-29 -Changed the SPI harness
    [Sensors + CAN.SchDoc]
2018-10-29 -Deleted dependency to an old Sensors.harness
    [e-puck3-coreboard.PrjPcb]
2018-11-01 Updated footprint of ACS711KEXLT-15AB-T : 12-PowerWFQFN
2018-11-01 Updated schematic symbol of ACS711KEXLT-15AB-T
    [Schlib.SchLib]
2018-11-01 Updated use of ACS711KEXLT-15AB-T in schematic
    [Power.SchDoc]
2018-11-05 -Connected ACS711 hall current sensor chip in power sheet
    [Power.SchDoc]
2018-11-05 -Added wlcsp9 - ti footprint (for TPD2S300) -Added TPD2S300 schematics -Added 0201 usb protection diode footprint -Added ESDL20-1BF4 vbus protection diode -Added ECMF02-2BF3 footprint -Added ECMF02-2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
    [Schlib.SchLib]
2018-11-05 -Changed the status led connection
    [Wireless.SchDoc]
2018-11-05 -Added USB-C CC lines protection -Added VBus protection diode -Added DP-DM protection diode
    [USB.SchDoc]
2018-11-05 -Added connections to the GPIOs of the ESP32
    [Wireless.SchDoc]
2018-11-05 -Added Extension_Connectors sheet
    [Extension_Connectors.SchDoc, e-puck3-coreboard.PrjPcb]
2018-11-05 -Added Programmer sheet
    [Programmer.SchDoc, e-puck3-coreboard.PrjPcb]
2018-11-07 -Added voltage divider to sense VBUS -Changed a resistor of the voltage divider of the DC/DC (402K -> 390K)
    [Power.SchDoc]
2018-11-07 -Added VBus pin to USB harness
    [USB.SchDoc]
2018-11-07 -Added uart control flow harness -Added control flow pin to uart0 (connected with the programmer) -Added name of the UART ports used
    [Wireless.SchDoc]
2018-11-07 -First draft of the connections of the programmer
    [Programmer.SchDoc]
2018-11-07 -Removed Underline effect on the names of the RGB Harness
    [Leds.SchDoc]
2018-11-07 -Added STM32CubeMX programmer file
2018-11-07 Updated ACS711KEXLT-15AB-T
    1) Footprint 12-PowerWFQFN with 100% opacity of case
    2) Schematic symbol easier to read, electrical type of pin corrected and resized
    3) Updated use of component in Power sheet
    [Power.SchDoc, Schlib.SchLib]
2018-11-08 -Added note on PC13, PC14 and PC15 pins
    [Programmer.SchDoc]
2018-11-08 -Corrected the schematics of the transistors
    [Power.SchDoc, Schlib.SchLib]
2018-11-12 -Added ESCs_2S sheet
    [ESCs_2S.SchDoc, e-puck3-coreboard.PrjPcb]
2018-11-12 -Added measurements of Battery current and battery voltage
    [Power.SchDoc]
2018-11-15 Updated ACS711KEXLT-15AB-T
    1) corrected SS and ILM pins in output
    [Schlib.SchLib]
2018-11-19 Updated footprints - 0201 DIODE - DFN1010B-6 - VQFN-HR (RUX) 12 - QFN-FCMOD (RKH) 9 - 12-POWERWFQFN
2018-11-19 Updated RB751S-40DP-TP symbol : pin 1 MUST be the cathode and 2 the anode
    [Schlib.SchLib]
2018-11-19 - Annoted - Updated the fields : Address1, Address2 and Title
    [Leds.SchDoc, Power.SchDoc]
2018-11-19 Updated footprints - LUMEX_SML-LX0404SIUPGUSB
2018-11-21 Updated ICM-20602 symbol
    Added STM32F74XZXY for STM32FG476ZxY
    Added STM32F77XAXY for STM32F778AxY
    [Schlib.SchLib]
2018-11-21 Updated STM32F74XZXY
    [Schlib.SchLib]
2018-11-21 -Added R equivalent values for each line to measure with an ADC
    [ESCs_2S.SchDoc, Power.SchDoc]
2018-11-21 -Changed MCO1 to MCO2 in order to generate a 26MHz clock for the STM32F76x
    [Programmer.SchDoc]
2018-11-21 -Changed stm32f413 to stm32f746 for the programmer
    [Programmer.SchDoc]
2018-11-21 -Added new STM32CubeMX pinout files
2018-11-21 Updated STM32F74XZXY and STM32F77XAXY Added Not FV tolerant info
    [Schlib.SchLib]
2018-11-21 Added: WLCSP-143 WLCSP-180
    Updated:
    12-PowerWFQFN
    0201 diode
    DFN1010B-6
    PQFN50P300X300X80-16N
    VQFN-HR (RUX) 12
2018-11-22 -Added connections to the programmer -Updated stm32f746 schematic
    [Programmer.SchDoc]
2018-11-22 -Renamed ESCs_2S to ESC_2S and now only one ESC is present on the sheet
    [ESC_2S.SchDoc, ESCs_2S.SchDoc, e-puck3-coreboard.PrjPcb]
2018-11-22 -Added PMDXB1200UPE dual p channel transistor
    [Schlib.SchLib]
2018-11-22 -Added transistors for the VUSB and VBAT measurements
    [Power.SchDoc]
2018-11-26 -Added a note to check the pin's behavior of the programmer when in bootloader mode
    [Programmer.SchDoc]
2018-11-27 -Changed the schematic to have two motors on one sheet
    [ESC_2S.SchDoc]
2018-11-27 -Renamed ESC_2S to 2Motors_ctrl_2S
    [2Motors_ctrl_2S.SchDoc, ESC_2S.SchDoc, e-puck3-coreboard.PrjPcb]
2018-11-28 -Placed 2 times the 2Motors_ctrl_2S sheet and annotated correctly the transistors
    [2Motors_ctrl_2S.SchDoc, Main.SchDoc, e-puck3-coreboard.PrjPcb]
2018-11-28 -Added missing ports
    [2Motors_ctrl_2S.SchDoc, Extension_Connectors.SchDoc, Leds.SchDoc, Power.SchDoc, Programmer.SchDoc, Sensors + CAN.SchDoc, USB.SchDoc, Wireless.SchDoc]
2018-11-28 -Added sheets symbols and changed the sheet size to A3
    [Main.SchDoc]
2018-11-28 -Added Main_uC sheet
    [Main_uC.SchDoc, e-puck3-coreboard.PrjPcb]
2018-11-28 -Added connections
    [Main.SchDoc, e-puck3-coreboard.PrjPcb]
2018-11-28 -Various ports corrections
    [Main.SchDoc, Main_uC.SchDoc, Wireless.SchDoc]
2018-11-29 -Added the last pins to use with the main_uC
    [Main.SchDoc, Main_uC.SchDoc]
2018-11-29 -Changed the order of the sheets in the Altium view
    [e-puck3-coreboard.PrjPcb]
2018-11-29 -Grouped the GPIOs of the ESP32 into harness ports
    [Main.SchDoc, Programmer.SchDoc, Wireless.SchDoc]
2018-11-30 -Grouped the measurement pins into a harness port
    [Main.SchDoc, Power.SchDoc, Programmer.SchDoc, e-puck3-coreboard.PrjPcb]
2018-11-30 -Added the Bootloader's pins behavior check -Changed some pins -Added two ports to enable the cameras
    [Main.SchDoc, Main_uC.SchDoc]
2018-11-30 -Added 5 gpios to the programmer
    [Main.SchDoc, Programmer.SchDoc]
2018-11-30 -Deleted an orphan comment
    [Power.SchDoc]
2018-12-03 -Added connections to the extension connectors
    [Extension_Connectors.SchDoc, Main.SchDoc, Power.SchDoc, e-puck3-coreboard.PrjPcb]
2018-12-03 -Corrected sheet's infos
    [2Motors_ctrl_2S.SchDoc, Extension_Connectors.SchDoc, Leds.SchDoc, Main.SchDoc, Main_uC.SchDoc, Power.SchDoc, Programmer.SchDoc, Sensors + CAN.SchDoc]
2018-12-03 -Changed the ADC3_TRIG to a single port connected between the prog and the uC (no more on the extension connector) -Added the /uC_RESET connection
    [Extension_Connectors.SchDoc, Main.SchDoc, Main_uC.SchDoc, Programmer.SchDoc]
2018-12-03 -Moved the supply pins of the prog
    [Main.SchDoc]
2018-12-03 -Added pins name -Corrected RGB leds order
    [Main_uC.SchDoc]
2018-12-04 -Added the motors connections to the extension connectors -Rearranged the extension connectors
    [2Motors_ctrl_2S.SchDoc, Extension_Connectors.SchDoc, Main.SchDoc]
2018-12-04 -Added motor's names in the bootloading behavior note
    [Programmer.SchDoc]
2018-12-04 Added FLE-135-01-G-DV-A connector
    [Schlib.SchLib]
2018-12-04 Added ACS711KEXLT-31AB-T component
    [Schlib.SchLib]
2018-12-04 -Added a resistance for each P-MOS to support up to 4S battery -Added a note -Reset of the annotation
    [2Motors_ctrl_2S.SchDoc, e-puck3-coreboard.PrjPcb]
2018-12-04 -Corrected the resistances for the voltage measurements and added comments
    [Power.SchDoc]
2018-12-04 -Added comment boot transistor
    [Programmer.SchDoc]
2018-12-04 -Moved the Power command to the PowerPath instead of the DC/DC to consume less when turned OFF
    [Power.SchDoc]
2018-12-04 -Changed ACS711 15A to 31A
    [Power.SchDoc]
2018-12-04 -Corrected RGB leds order
    [Programmer.SchDoc]
2018-12-04 -Added power connections to the main_uC
    [Main.SchDoc, Main_uC.SchDoc, Power.SchDoc]
2018-12-04 -Added USER, BOOT and RESET buttons to the main_uC
    [Main_uC.SchDoc]
2018-12-04 -Changed the power pins because of the bootloader behavior
    [Main_uC.SchDoc]
2018-12-06 -Corrected the UART connections
    [Extension_Connectors.SchDoc, Main.SchDoc, Main_uC.SchDoc, Programmer.SchDoc, Sensors + CAN.SchDoc, Wireless.SchDoc]
2018-12-06 -Added /CS_IMU
    [Main.SchDoc, Main_uC.SchDoc]
2018-12-10 -Corrected an error of DCMI_D6 harness's pin -Corrected misplaced power connections on the Extension_connectors sheet
    [Extension_Connectors.SchDoc, Main.SchDoc]
2018-12-11 -Annotated the components -Added net names on the top level sheet to avoid duplicated net names -Corrected off grid placement of some net names
    [2Motors_ctrl_2S.SchDoc, Extension_Connectors.SchDoc, Leds.SchDoc, Main.SchDoc, Main_uC.SchDoc, Power.SchDoc, Programmer.SchDoc, Sensors + CAN.SchDoc]
2018-12-11 -Corrected error on the pin mapping of the STULPI01b USB HS transceiver
    [Schlib.SchLib, USB.SchDoc]
2018-12-20 -Added AS5055 encoder schematic and footprint
    [Schlib.SchLib]
2018-12-20 -Added missing pin assignments to the programmer stmcube file
    [Programmer_pinout.ioc]
2018-12-21 -Added comments on the interfaces used
    [Programmer.SchDoc]
2018-12-21 -Added SPI for the ecnoders AS5055 (changed UART4 to USART3) -Updated pin's behavior during bootloader comment
    [Extension_Connectors.SchDoc, Main.SchDoc, Programmer.SchDoc]
2018-12-21 -changed GPIO_input to EXTI in the stm32cube file
    [Main_uC.SchDoc]
2019-01-07 -Corrected wrong net name
    [2Motors_ctrl_2S.SchDoc]
2019-01-07 -Corrected AS5055 schematic
    [Schlib.SchLib]
2019-01-07 -Corrected comment
    [Programmer.SchDoc]
2019-01-08 -Changed expansion mask from 0.02mm to 0.05mm for WLCSP9 footprint -Added color to show where is the negative side for the 0201 diode footprint
2019-01-08 -Removed VCONN connection from the FUSB302 chip
    [USB.SchDoc]
2019-01-09 -Added a 0201 Zener diode in the lib -Replaced the voltage dividers of the TPS2121 by resistors + zener diodes
    [Power.SchDoc, Schlib.SchLib, e-puck3-coreboard.PrjPcb]
2019-01-09 -Changed the pin's positions for the AS5055A
    [Schlib.SchLib]
2019-01-16 -Added SIZ322DT transistor to the library
    [Schlib.SchLib]
2019-01-16 -Renamed SPI_ENCODERS to SPI_BUS_prog -Added 4 pins to control the four CS of the four DRV8323 that will be added
    [Extension_Connectors.SchDoc, Main.SchDoc, Programmer.SchDoc]
2019-01-16 -Added 4 pins to control the ENABLE pins of the DRV8323 which will be added
    [Programmer.SchDoc]
2019-01-17 -Added DRV8323S with the updates to the library
    [Schlib.SchLib]
2019-01-17 -Removed the FREE_GPIOs from the programmer and added 4 pins for the FAULT pins of the DRV8323S -Changed some pins to have each input on a different exti
    [Extension_Connectors.SchDoc, Main.SchDoc, Programmer.SchDoc]
2019-05-23 -Updated the IMT-LSRO to Mobots identity -Specified that gate's drivers are missing
    [2Motors_ctrl_2S.SchDoc, Extension_Connectors.SchDoc, Leds.SchDoc, Main.SchDoc, Main_uC.SchDoc, Power.SchDoc, Programmer.SchDoc, Sensors + CAN.SchDoc]
2019-08-20 Modif Dany : Préparation documents pour ST
    [e-puck3-coreboard.PrjPcb]
2019-08-20 -Updated the libs accordingly to the changes made in the motor_dev project
    [Schlib.SchLib]
2019-08-20 -Corrected the pinout order of the maxon motors connectors
2019-08-20 -Added 26MHz clock -Deleted STM32F746 Pinout -Replaced 24MHz clock by 26MHz clock and renamed corresponding signals
    [Main.SchDoc, Programmer.SchDoc, Schlib.SchLib]
2019-08-20 -Deleted the current measurements and updated the harness connectors
    [Power.SchDoc, Programmer.SchDoc]
2019-08-21 -Updated the ESCs schemes and harness connectors
    [2Motors_ctrl_2S.SchDoc, ESC_2S-5S.SchDoc, Main.SchDoc, Programmer.SchDoc, Schlib.SchLib, e-puck3-coreboard.PrjPcb]
2019-08-21 -Updated the Power related part to uses two DC/DCs to replace the powerpath -Changed a title in the ESC sheet
    [ESC_2S-5S.SchDoc, Power.SchDoc, Programmer.SchDoc]
2019-08-22 -Added FDMC8010DC transistor -Moved all Outline objects to TopBody
    [Schlib.SchLib]
2019-08-23 -Updated the power part
    [Main.SchDoc, Power.SchDoc, Programmer.SchDoc]
2019-08-23 -Updated harness connectors and connexions
    [ESC_2S-5S.SchDoc, Main.SchDoc, Power.SchDoc, Programmer.SchDoc]
2019-08-29 -Update to the power management part
    [Main.SchDoc, Power.SchDoc, Programmer.SchDoc]
2019-08-29 -Added a bead inductor (reduces noise on alimentation)
    [Schlib.SchLib]
2019-08-29 -Changed the reset conditions to let everything disabled by default (except the programmer)
    [ESC_2S-5S.SchDoc, Main_uC.SchDoc, Power.SchDoc, Programmer.SchDoc, USB.SchDoc, Wireless.SchDoc]
2019-08-30 -Changed the resistors values for the feedback
    [Power.SchDoc]
2019-08-30 -Added a transistor to force the reset of the main uC when the programmer is not controlling it
    [Programmer.SchDoc]
2019-08-30 -Added a power surge diode
    [Schlib.SchLib]
2019-08-30 -Changed the VBUS diode protection to a available one -Changed the feedback resistors values to available ones
    [Power.SchDoc, USB.SchDoc]
2019-09-02 -Added the lsm6dsr imu
    [Schlib.SchLib]
2019-09-03 -Changed the IMU for the ST LSM6DSR
    [Main.SchDoc, Main_uC.SchDoc, Sensors + CAN.SchDoc]
2019-09-03 -Added the ST LPS22HH pressure sensor
    [Schlib.SchLib]
2019-09-03 -Added the pressure sensor to the system
    [Main.SchDoc, Main_uC.SchDoc, Sensors + CAN.SchDoc]
2019-09-03 -Added the TCAN334G Can transceiver
    [Schlib.SchLib]
2019-09-03 -Changed the Can transceivers to the TCAN334G
    [Sensors + CAN.SchDoc]
2019-09-04 -Added TLV9061 operational amplifier
    [Schlib.SchLib]
2019-09-05 -Changed the measurement circuits to use op amp
    [Main.SchDoc, Power.SchDoc, Programmer.SchDoc]
2019-09-06 -Added the TCK401G gate driver
    [Schlib.SchLib]
2019-09-06 -Added a gate driver to control the power mosfet used to limit the inrush current
    [Power.SchDoc]
2019-09-06 -Renamed the power nets from 3.3V to 3V and VBAT to BAT+. Added BAT- -Added the ESCs to the main sheet
    [ESC_2S-5S.SchDoc, Extension_Connectors.SchDoc, Leds.SchDoc, Main.SchDoc, Main_uC.SchDoc, Power.SchDoc, Programmer.SchDoc, Sensors + CAN.SchDoc]
2019-09-06 -Added a 24MHz clock to be able to correctly clock the two microcontrollers and the USB HS Transceiver and Hub
    [Main.SchDoc, Main_uC.SchDoc, Programmer.SchDoc, Schlib.SchLib, USB.SchDoc]
2019-09-06 -Added the USB3333 USB HS Transceiver
    [Schlib.SchLib]
2019-09-06 -Changed the USB HS Trancseiver to the USB3333
    [Main.SchDoc, Main_uC.SchDoc, USB.SchDoc]
2019-09-06 -Added LSM6DSOX IMU
    [Schlib.SchLib]
2019-09-09 -Replaced the IMU by the LSM6DSOX
    [Sensors + CAN.SchDoc]
2019-09-09 -New pinout of the programmer to avoid DMA conflicts
    [Main.SchDoc, Programmer.SchDoc, USB.SchDoc]
2019-09-12 -New pinout for the main_uC to avoid DMA conflicts
    [Extension_Connectors.SchDoc, Main.SchDoc, Main_uC.SchDoc]
2019-09-12 -Changed the connections for the encoders
    [Extension_Connectors.SchDoc, Main.SchDoc, Programmer.SchDoc]
2019-09-12 -Rearranged the extension connectors -Added 2 pins to control the power of the bottom and top extensions
    [Extension_Connectors.SchDoc, Main.SchDoc, Main_uC.SchDoc, Programmer.SchDoc]
2019-09-12 -Added an onboard distance sensor
    [Main.SchDoc, Main_uC.SchDoc, Sensors + CAN.SchDoc]
2019-09-12 -Added a sheet for the cameras connectors and the SD card reader
    [Camera_sdcard.SchDoc, Main.SchDoc, e-puck3-coreboard.PrjPcb]
2019-09-19 -Checked and updated the Bootloader's pins behavior with the actual connections for the main uC and the programmer -Added serie resistances for the VBUS of the main uC and the programmer -completed t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
    [Extension_Connectors.SchDoc, Main_uC.SchDoc, Programmer.SchDoc, USB.SchDoc]
2019-09-20 -Connected the motors phases to the extension sheet
    [ESC_2S-5S.SchDoc, Extension_Connectors.SchDoc, Main.SchDoc]
2019-09-20 -Corrected Input pins
    [Camera_sdcard.SchDoc, Main.SchDoc]
2019-09-20 -Annotated the components
    [ESC_2S-5S.SchDoc, Extension_Connectors.SchDoc, Leds.SchDoc, Main.SchDoc, Main_uC.SchDoc, Power.SchDoc, Programmer.SchDoc, Sensors + CAN.SchDoc]
2019-09-20 -Corrected input pin for USB3333
    [Schlib.SchLib, USB.SchDoc]
2019-09-23 -Verified each warning and error
    [ESC_2S-5S.SchDoc, Extension_Connectors.SchDoc, Main.SchDoc, Main_uC.SchDoc, Power.SchDoc, Programmer.SchDoc, Sensors + CAN.SchDoc, USB.SchDoc]
2019-09-24 -Added programming pads
    [Programmer.SchDoc, Schlib.SchLib]
2019-09-24 -Changed the value of the serie resistors from 1K to 100K
    [USB.SchDoc]
2019-09-25 -Added USB3803 USB Hub
    [Schlib.SchLib]
2019-09-25 -Added a gate driver to the VBUS pin of the PHY HS to have more than 3V -Added VBUS_HOST input to the prog -Added VBUS_DEVICES output to the prog -Replaced the USB2513 USB Hub by the USB3803 -Updated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
    [ESC_2S-5S.SchDoc, Main.SchDoc, Main_uC.SchDoc, Power.SchDoc, Programmer.SchDoc, Schlib.SchLib, Sensors + CAN.SchDoc, USB.SchDoc]
2019-09-25 -Corrected pin location on USB3803 -Removed I2C2. Now the HUB and the PD controller are on the same bus
    [Schlib.SchLib, USB.SchDoc]
2019-09-26 -Connected the ESP32 to the programmer
    [Main.SchDoc, Power.SchDoc, Programmer.SchDoc, Wireless.SchDoc]
2019-09-27 -Added FLE-128 and FLE-114 -Inverted the pinout for the FLE connectors
    [Schlib.SchLib]
2019-09-27 -Made the connections with the extension connectors
    [Camera_sdcard.SchDoc, Extension_Connectors.SchDoc, Main.SchDoc, Wireless.SchDoc]
2019-09-30 -Added a pull-down to BOOT0 of the programmer
    [ESC_2S-5S.SchDoc, Programmer.SchDoc]
2019-09-30 -Added missing capacitors for main_uc
    [ESC_2S-5S.SchDoc, Main_uC.SchDoc, Power.SchDoc, Programmer.SchDoc, Sensors + CAN.SchDoc, USB.SchDoc, Wireless.SchDoc]
2019-09-30 -Updated bootloader note for main_uc
    [Main_uC.SchDoc]
2019-10-01 -Added SN74AUP2G32 OR gate
    [Schlib.SchLib]
2019-10-01 -Added OR gates to correct the behavior when we want to program the programmer with the main_uc
    [ESC_2S-5S.SchDoc, Main.SchDoc, Programmer.SchDoc, Schlib.SchLib, USB.SchDoc, Wireless.SchDoc]
2019-10-02 -Corrected pinout ESP32
    [Extension_Connectors.SchDoc, Main.SchDoc, Wireless.SchDoc]
2019-10-02 -Re annotated
    [ESC_2S-5S.SchDoc, Leds.SchDoc, Power.SchDoc, Programmer.SchDoc, USB.SchDoc, Wireless.SchDoc]
2019-10-03 -Added small SD card receptacle
    [Schlib.SchLib]
2019-10-03 -Removed the remaining ADC1 pin to replace it by the missing /SD_DETECT signal -Connected the SD card receptacle
    [Camera_sdcard.SchDoc, Extension_Connectors.SchDoc, Main_uC.SchDoc]
2019-10-03 -Changed the GND style
    [ESC_2S-5S.SchDoc]
2019-10-03 -Modified the SD card receptacle schematic
    [Schlib.SchLib]
2019-10-03 -Added camera connectors and annotated
    [Camera_sdcard.SchDoc, Programmer.SchDoc]
2019-10-04 -Added a transistor to control the LEDS for the bottom camera -Added /OE for the 2 cameras -Removed the UART8 from the main_uc to gain 4 pins -Connected the main_uc to the force_main_uc signal
    [Camera_sdcard.SchDoc, Extension_Connectors.SchDoc, Main.SchDoc, Main_uC.SchDoc, Programmer.SchDoc]
2019-10-04 -Added MIC5504 1.2V LDO
    [Schlib.SchLib]
2019-10-04 -Added the 1.2V LDO for the cameras
    [Camera_sdcard.SchDoc, Main.SchDoc, Power.SchDoc]
2019-10-04 -Updated annotations
    [Camera_sdcard.SchDoc, ESC_2S-5S.SchDoc, Power.SchDoc, Programmer.SchDoc, Sensors + CAN.SchDoc, Wireless.SchDoc]
2019-10-07 -Connected the new signals to the main_uC -Annotated the last added button
    [Main_uC.SchDoc, Programmer.SchDoc]
2019-10-07 -Added brushless connectors for the drone motors
    [ESC_2S-5S.SchDoc, Main.SchDoc, Main_uC.SchDoc, Schlib.SchLib]
2019-10-07 -Added the SMD version of the brushless connector
    [Schlib.SchLib]
2019-10-08 -Added a power connector
    [Schlib.SchLib]
2019-10-08 -Added the battery solder vias
    [Extension_Connectors.SchDoc, Power.SchDoc]
2019-10-15 -Moved a signal
    [Extension_Connectors.SchDoc, Main_uC.SchDoc]
2019-10-17 -Added comment on the USB hub
    [USB.SchDoc]
2019-10-17 -Changed the order of the sheets and re-annotated accordingly
    [Camera_sdcard.SchDoc, ESC_2S-5S.SchDoc, Extension_Connectors.SchDoc, Leds.SchDoc, Main.SchDoc, Main_uC.SchDoc, Power.SchDoc, Programmer.SchDoc]
2019-10-23 -Added a the TTGO micro-32 ESP32 module
    [Schlib.SchLib]
2019-10-24 -Added the MP6542A 3 integrated half-bridges
    [Schlib.SchLib]
2019-10-24 -Updated the ESC with a the MP6542A integrated 3 half-bridges chip
    [ESC_2S-5S.SchDoc, Programmer.SchDoc]
2019-10-25 -Completed the TTGO micro-32 part -Changed the 22uF 35V capacitors -Reannotated
    [Camera_sdcard.SchDoc, ESC_2S-5S.SchDoc, Leds.SchDoc, Power.SchDoc, Programmer.SchDoc, Schlib.SchLib, Sensors + CAN.SchDoc, USB.SchDoc]
2019-10-25 -Replaced the ESP-32S by the TTGO micro-32
    [Extension_Connectors.SchDoc, Main.SchDoc, Programmer.SchDoc, Wireless.SchDoc]
2019-10-29 -Added I2C to the camera bus
    [Camera_sdcard.SchDoc, Main.SchDoc, Main_uC.SchDoc, e-puck3-coreboard.PrjPcb]
2019-10-30 -Corrected the MP6542A pin 9
    [ESC_2S-5S.SchDoc, Schlib.SchLib]
2019-10-30 -Added the footprint for the SN74AUP2G32YFPR double OR gate
    [Programmer.SchDoc, Schlib.SchLib]
2019-10-30 -Deleted the FOV cone of the distance sensors (VL5x)
2019-10-31 -Created the PCB file
    [e-puck3-coreboard.PrjPcb]
2019-10-31 -Unified the footprints
2019-10-31 -Updated the footprints
2019-11-05 -Moved the components to have a new layout -Adapted the pinout of the extension's connectors for the layout
    [Extension_Connectors.SchDoc]
2019-11-06 -Changed some pinout to simplify the routing
    [Extension_Connectors.SchDoc, USB.SchDoc]
2019-11-07 -Modified the stm32f778 wlcsp180 footprint
2019-11-07 -Routing tests for 0.4mm WLCSP
    [e-puck3-coreboard.PrjPcb]
2019-11-07 -Modified the wlcps 143 footprint
2019-11-07 -tests for 0.4mm routing
2019-11-11 Update footprint TTGO Micro-32 (ESP32)
    Added keepout under the module
2019-11-11 -Added solder paste to the Vishay IR sensor
2019-11-11 -avant test avec que des microvias
    [e-puck3-coreboard.PrjPcb]
2019-11-11 -Test avec que des microvias
2019-11-11 -Added the modifs of the TTGO Micro-32 footprint from Daniel 3 commits below
2019-11-11 -Updated the Micro-32 footprint on the pcb
    [e-puck3-coreboard.PrjPcb]
2019-11-15 -Routing the Power part
    [Extension_Connectors.SchDoc]
2019-11-18 -Uniformized all the WLCSP footprints
2019-11-18 -Added capacitors and corrected the capacitors value for the CC lines
    [USB.SchDoc]
2019-11-18 -Updated some capacitors name
    [ESC_2S-5S.SchDoc, Main_uC.SchDoc, USB.SchDoc]
2019-11-18 -Rotated some footprints
2019-11-19 -Added capacitor to the two charge pumps and connected a button to ground
    [Power.SchDoc, Programmer.SchDoc, USB.SchDoc]
2019-11-21 -Routing the power part -Moved the connections on the extension connectors to match their positioning on the board
    [Extension_Connectors.SchDoc]
2019-11-25 -Deleted the D12 and D13 pin of DCMI and added EXTCLK
    [Camera_sdcard.SchDoc, Main.SchDoc, Main_uC.SchDoc, e-puck3-coreboard.PrjPcb]
2019-11-25 -Updated the DSBGA 8-pin and TDFN-4 footprints
2019-11-25 -Changed some resistor's comment
    [Power.SchDoc, Programmer.SchDoc, USB.SchDoc]
2019-11-25 -Connected the camera connectors
    [Camera_sdcard.SchDoc, Main.SchDoc]
2019-11-26 -Added a capacitor for the USB Hub -Routing the USB part
    [USB.SchDoc]
2019-11-28 -Routing the USB part -Added a capacitor for the USB PD line protection
    [USB.SchDoc]
2019-11-28 -Routing the capacitors of the main uC
2019-11-29 -Routing the capacitors of the programmer
2019-11-29 -Routing the cameras
2019-12-03 -Connected the flash_cam2 pin to the bottom extension connectors -Removed one adc pin from the bottom extension connectors
    [Camera_sdcard.SchDoc, Extension_Connectors.SchDoc, Main.SchDoc]
2019-12-11 -Routing the analog motor part
2019-12-11 -Corrected the resistors values for the LEDs
    [Leds.SchDoc]
2019-12-11 -Routing the motor control part
2019-12-13 -Routing camera and USB HS parts
2020-01-08 -Removed the names of the unused pins
    [Wireless.SchDoc]
2020-01-09 -Routing microcontroller's signals -Reorganized the 3V power supply paths
2020-01-09 -Routing microcontroller's signals -Correcting the power part accordingly to the new layers added before
    [Extension_Connectors.SchDoc]
2020-01-13 -Routing microcontroller's signal -Moved GND pins on one extension connector for routing reasons
    [Extension_Connectors.SchDoc]
2020-01-14 -Routing microcontroller's signal -Moved pins on one extension connector for routing reasons
    [Extension_Connectors.SchDoc]
2020-01-16 -Routed the last microcontroller's signals -moved signals on an external connector for routing purpose
    [Extension_Connectors.SchDoc]
2020-01-20 -Added a solder mask opening for the DFN1010B-6 component -Corrected some errors
2020-01-22 -Corrected the pull-up values for the I2C address selection of the cameras
    [Camera_sdcard.SchDoc]
2020-01-22 -Added Max voltage informations
    [ESC_2S-5S.SchDoc, Power.SchDoc]
2020-01-22 -Cosmetic changes to the overlay and the board color
2020-01-23 -Changed a resistor value to be able to measure up to 20V for the battery -Changed the threshold detection for VBUS_HOST
    [Power.SchDoc]
2020-01-23 -Cosmetic corrections of the traces
2020-01-29 -Removed some power loops
2020-01-30 -Simplified the 3V and GND connections thanks to the new ground planes -Correced the Vias for the new added layers
    [e-puck3-coreboard.PrjPcb]
2020-01-30 -Better tuned the impedance of the USB traces -Moved some ULPI traces
2020-01-31 -Cosmetic changes -Output job configured -Draftman modified
    [Sensors + CAN.SchDoc, e-puck3-coreboard.PrjPcb]
2020-01-31 -Added a variant
    [e-puck3-coreboard.PrjPcb]
2020-02-03 -Adding and filling properties fields of the components to have a correct BOM
    [Camera_sdcard.SchDoc, ESC_2S-5S.SchDoc, Extension_Connectors.SchDoc, Leds.SchDoc, Main.SchDoc, Main_uC.SchDoc, Power.SchDoc, Programmer.SchDoc]
2020-02-03 -Adding and filling properties fields of the components to have a correct BOM -Changed the STM32f778 to an STM32F779 because of unavailability (there are the same)
    [Camera_sdcard.SchDoc, ESC_2S-5S.SchDoc, Extension_Connectors.SchDoc, Leds.SchDoc, Main.SchDoc, Main_uC.SchDoc, Power.SchDoc, Programmer.SchDoc]
2020-02-04 -Completed the fields for the BOM
    [Camera_sdcard.SchDoc, ESC_2S-5S.SchDoc, Extension_Connectors.SchDoc, Leds.SchDoc, Main.SchDoc, Main_uC.SchDoc, Power.SchDoc, Programmer.SchDoc]
2020-02-04 -Added instructions on how to edit the custom font used in the overlay of the PCB
2020-02-06 -Corrected value of resistors -Correct Draftman and BOM
    [Power.SchDoc, Sensors + CAN.SchDoc, USB.SchDoc]
2020-02-06 -Removed drawings on the Top and Bottom designator layers -Added pin indication for every footprint used -Added Catode indication for diode footprints -Harmonized the footprints
    [Schlib.SchLib]
2020-02-10 -Corrected the 3d body not updated of the RGB leds and the distance sensor -Changed some overlays -Added fiducials on top and bottom layers
2020-02-12 -Removed solder paste for the fiducial marks
2020-02-12 -Added a panel to test -Renamed wrong name for the pdf output files -Added notes on the fabrication in he draftman
    [e-puck3-coreboard.PrjPcb, e-puck3-coreboard_panel.PcbDoc]
2020-02-14 -Changed R83 from 5K to 4K7 to avoid a single value resistor
    [Programmer.SchDoc]
2020-02-15 -Changed R6 from 10K to 4K7 to avoid single value resistor
    [Programmer.SchDoc, e-puck3-coreboard.PrjPcb]
2020-02-15 -Changed a field from "To buy by PCBWay" to "To buy by assembler" -Changed the output path for Telsa
    [Camera_sdcard.SchDoc, ESC_2S-5S.SchDoc, Extension_Connectors.SchDoc, Leds.SchDoc, Main.SchDoc, Main_uC.SchDoc, Power.SchDoc, Programmer.SchDoc]
2020-02-17 -Cosmetic corrections of the shematics
    [Camera_sdcard.SchDoc, ESC_2S-5S.SchDoc, Extension_Connectors.SchDoc, Leds.SchDoc, Main.SchDoc, Main_uC.SchDoc, Power.SchDoc, Programmer.SchDoc]
2020-02-17 -Added NC Drill metric file generation
    [e-puck3-coreboard.PrjPcb]
2020-02-21 -Corrected the notes about the flatness
    [e-puck3-coreboard.PrjPcb]
2020-05-08 -Corrected wrong Molex connector reference. 0530480250 -> 0530480350
    [ESC_2S-5S.SchDoc, Schlib.SchLib, e-puck3-coreboard.PrjPcb]
2020-05-08 -Corrected error in net_label placement in the ESC sheet The 3 phases_vsense were connected together (error appeared after the routing during the cosmetic changes -> no problem)
    [ESC_2S-5S.SchDoc]
2020-07-27 -Included the clock correction made on the boards (19.2MHz clock instead of 26MHz)
    [Programmer_pinout_rev1.ioc]
2020-07-27 -Swapped the D4/E4 pins on the USB hub to correct wrong input frequency
    [Schlib.SchLib, USB.SchDoc]
2020-07-27 -Removed VBus device + gate driver U15 from USB transceiver (wasn't working and useless)
    [USB.SchDoc]
2020-07-28 -Increased the size of the motors connectors pads
    [ESC_2S-5S.SchDoc]
2020-07-28 -Changed Rev 1.0 to Rev 1.1
    [e-puck3-coreboard.PrjPcb]
2020-07-29 -Added PMCXB900UELZ P and N mos dual transistor
    [Schlib.SchLib]
2020-07-29 -Added BSS84AKMB pmos
    [Schlib.SchLib]
2020-07-29 -Changed the power nmos control schematic
    [Main.SchDoc, Power.SchDoc, Programmer.SchDoc]
